karthikeyann/computerised-object-counter/EFY vc.pdf

# CONSTRUCTION

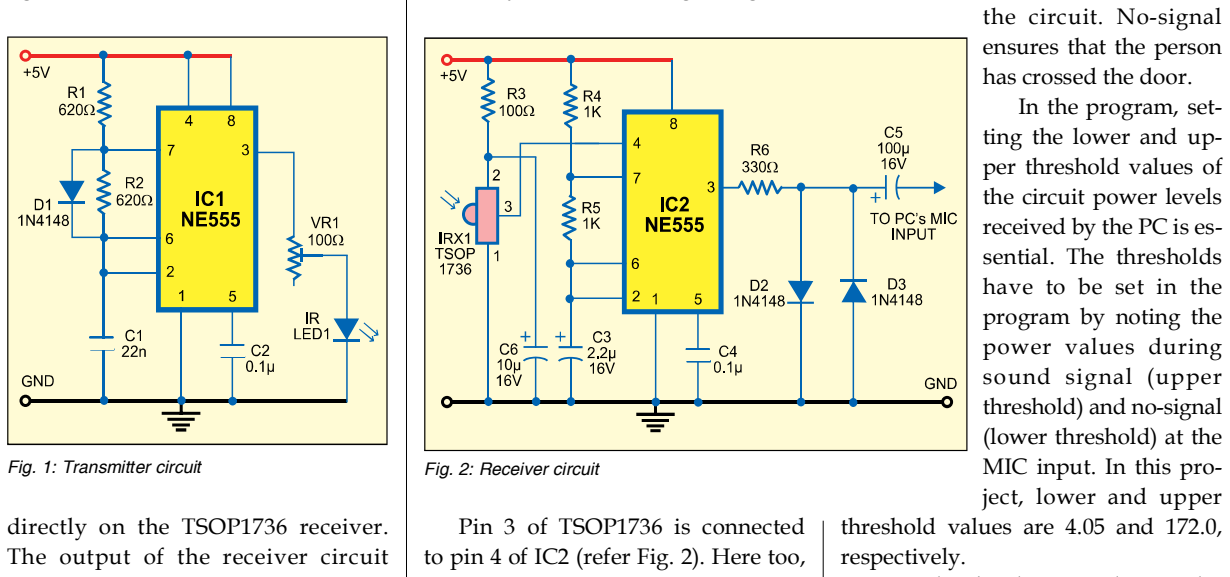
[picture p1: figure]
directly on the TSOP1736 receiver.; Pin 3 of TSOP1736 is connected; the circuit. No-signal ensures that the person has crossed the door. In the program, set- ting the lower and up- per threshold values of the circuit power levels received by the PC is es- sential. The thresholds have to be set in the program by noting the power values during sound signal (upper threshold) and no-signal (lower threshold) at the MIC input. In this pro- ject, lower and upper threshold values are 4.05 and 172.0, respectively.

KARTHIKEYAN N.

# VISITOR COUNTER USING MATLAB

T
his circuit can also be used for object counting in conveyor systems, vehicle monitoring and intruder detection. It consists of a pair of IR transmitter and IR receiver—both built around timer IC NE555 (IC1 and IC2, respectively). The IR transmitter and receiver units are mounted on the opposite frames of the entrance door such that the light from IR LED1 transmitter falls

The output of the receiver circuit is fed to MIC input of the PC. The program in MATLAB in the PC is used as the user-interface to count the number of visitors. The count can be stored in the PC, manipulated and used for statistical applications.
A visitor count is registered in the PC whenever someone blocks or interrupts the IR beam between the transmitter and the receiver. However, this does not indicate whether the visitor is going inside the room or leaving the room. This unidirectional counter counts the number of visitors within a range of about 1 metre between the transmitter and the receiver.
In the IR transmitter circuit (refer astable multivibrator that oscillates at a frequency of 36 kHz. This frequency modulates the IR light beam emitted by IR LED1. The brightness of IR LED1 can be adjusted using variable resistor VR1. TSOP1736 is an IR receiver normally used in TV remote control devices. It receives the IR signal transmitted by IR LED1. It is an active-low device, i.e., if it receives modulated IR light at a frequency of 36 kHz, its output pin 3 goes low. When it does not receive IR light at this frequency, its output pin 3 goes high.

to pin 4 of IC2 (refer Fig. 2). Here too,

Whenever input pin 4 of IC2 goes high, an audible frequency of about 240 Hz is generated at its output pin 3. So when pin 3 of TSOP1736 is high, it enables IC2.
Output pin 3 of IC2 is connected to either MIC or line-in input of the PC’s sound card. Diodes D2 and D3 protect the sound card from over-voltage. Normally, the IR beam from IR LED1 is falling on TSOP1736 and therefore its output pin 3 is always low, disabling IC2. As a result, the PC doesn’t receive the 240Hz sound signal.
When someone walks in to interrupt the IR beam, pin 3 of TSOP1736 goes high, which enables IC2 to generate 240Hz signal at its output pin

### 3. The PC receives the sound signal

through the MIC input. The MATLAB program registers the signal input and increments the counter by one count. The program increments the count only when it receives a sound signal followed by a ‘no-signal’ (silence) from

To check these values, the counter.m program code is used. Run this program in MATLAB version 7.0.1 and observe the values being displayed

Fig. 1: Transmitter circuit | Fig. 2: Receiver circuit

PARTS LIST
Semiconductors:
IC1, IC2 | - NE555 timer
IR LED1 | - 5mm IR Light emitting diode
D1-D3 | - 1N4148 signal diode
IRX1 | - TSOP1736 infrared sensor
Resistors (all ¼-watt, ±5% carbon)
R1, R2 | - 620-ohm
R3 | - 100-ohm
R4, R5 | - 1-kilo-ohm
R6 | - 330-ohm
VR1 | - 100-ohm preset
Capacitors:
C1 | - 22n ceramic
C2, C4 | - 0.1µF, ceramic
C3 | - 2.2µF, 16V electrolytic
C5 | - 100µF, 16V electrolytic
C6 | - 10µF, 16V electrolytic

# CONSTRUCTION

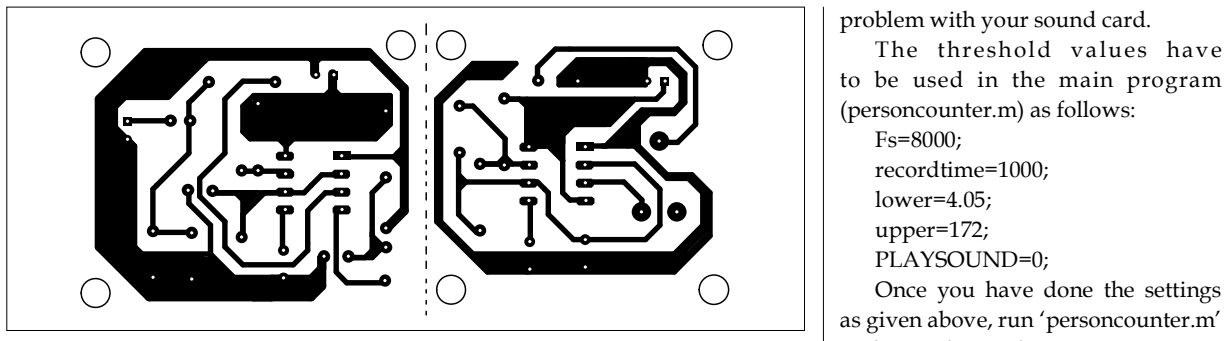
[picture p2: figure]
problem with your sound card. The threshold values have to be used in the main program (personcounter.m) as follows: Fs=8000; recordtime=1000; lower=4.05; upper=172; PLAYSOUND=0; Once you have done the settings as given above, run ‘personcounter.m’

Fig. 3: An actual-size, single-side combined PCB for transmitter and receiver circuits

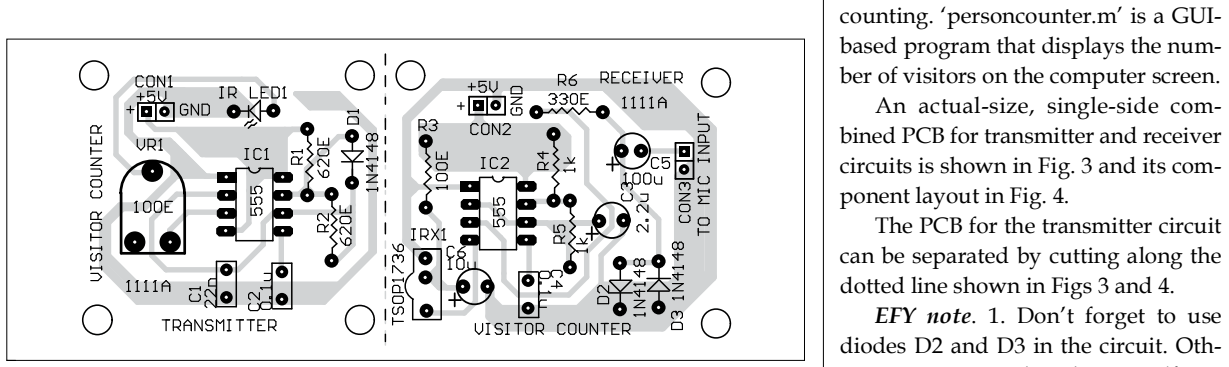
[picture p3: figure]
counting. ‘personcounter.m’ is a GUI- based program that displays the num- ber of visitors on the computer screen. An actual-size, single-side com- bined PCB for transmitter and receiver; ponent layout in Fig. 4. The PCB for the transmitter circuit can be separated by cutting along the dotted line shown in Figs 3 and 4. EFY note. 1. Don’t forget to use diodes D2 and D3 in the circuit. Oth-

Fig. 4: Component layout for the PCB

on the screen. It generates the values in text format in command window. If the and receiver circuits (it should be 5V) and also vary VR1 in the transmitter and switch on the circuits to start

circuits is shown in Fig. 3 and its com-

erwise, your sound card may malfunction. It may even cause permanent damage to the sound card.

### 2. The source codes of this article

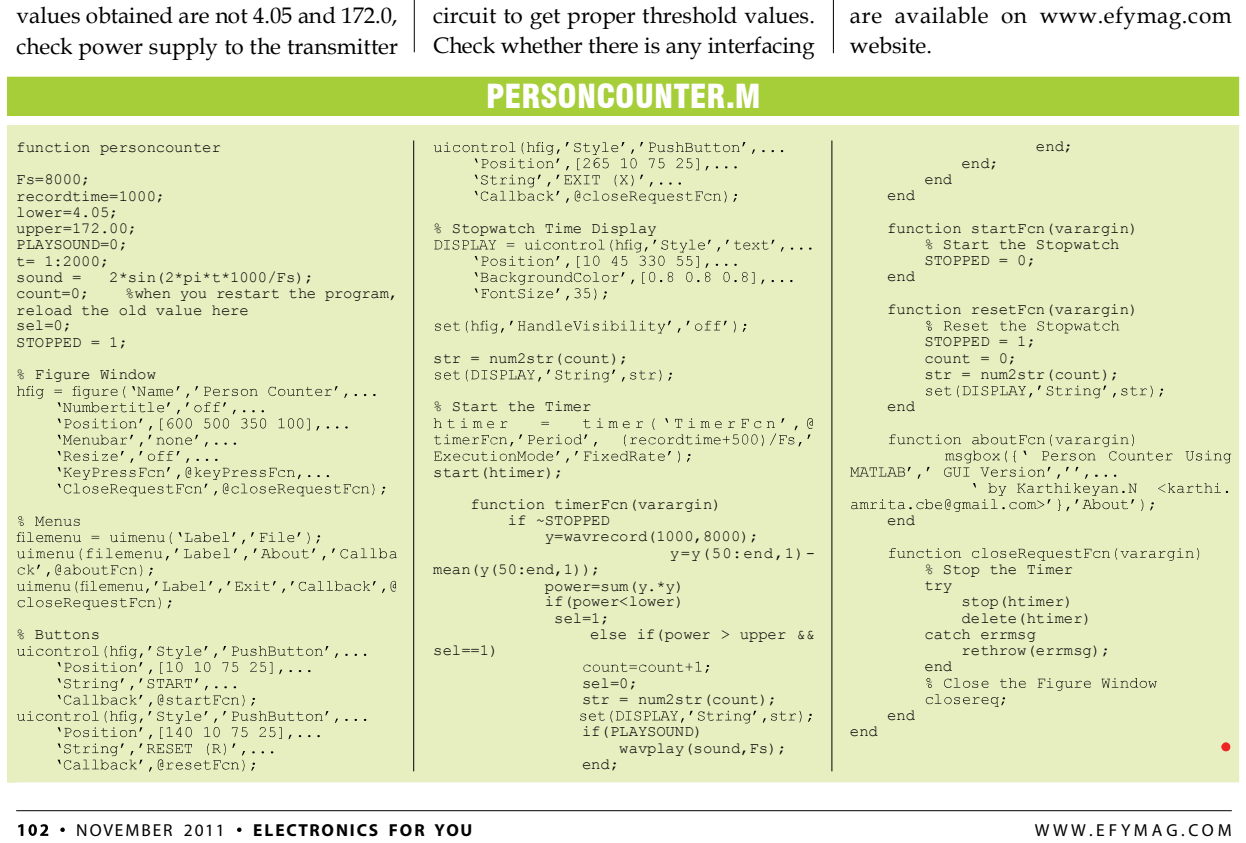
[picture p4: figure]
PERSONCOUNTER.M; function personcounter; Fs=8000; recordtime=1000; lower=4.05; upper=172.00; PLAYSOUND=0; t= 1:2000;; sound =; 2*sin(2*pi*t*1000/Fs);; count=0;; %when you restart the program,; reload the old value here sel=0; STOPPED = 1;; % Figure Window; % Buttons; % Stopwatch Time Display; str = num2str(count);; % Start the Timer; start(htimer);; function timerFcn(varargin) if ~STOPPED y=wavrecord(1000,8000); y=y(50:end,1)-; mean(y(50:end,1)); power=sum(y.*y) if(power<lower) sel=1; else if(power > upper &&; sel==1); sel=0; str = num2str(count);; if(PLAYSOUND) wavplay(sound,Fs); end;; end;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
