karthikeyann/computerised-object-counter/(list of files, drawings)

Other design files:
Personcounter.DSN
